etank7000/Skittle-Sorting-Machine/README.md

# Skittle-Sorting-Machine
UCLA EE 3 Spring 2016 Final Project.

Check out [this video demo](https://www.youtube.com/watch?v=cCzsu9h3R-A) of the Skittle Sorting Machine.
